ufonzak/weather-station/pcb/pcb.kicad_pcb

## KiCad design pcb/pcb.kicad_pcb (2021-03-13)

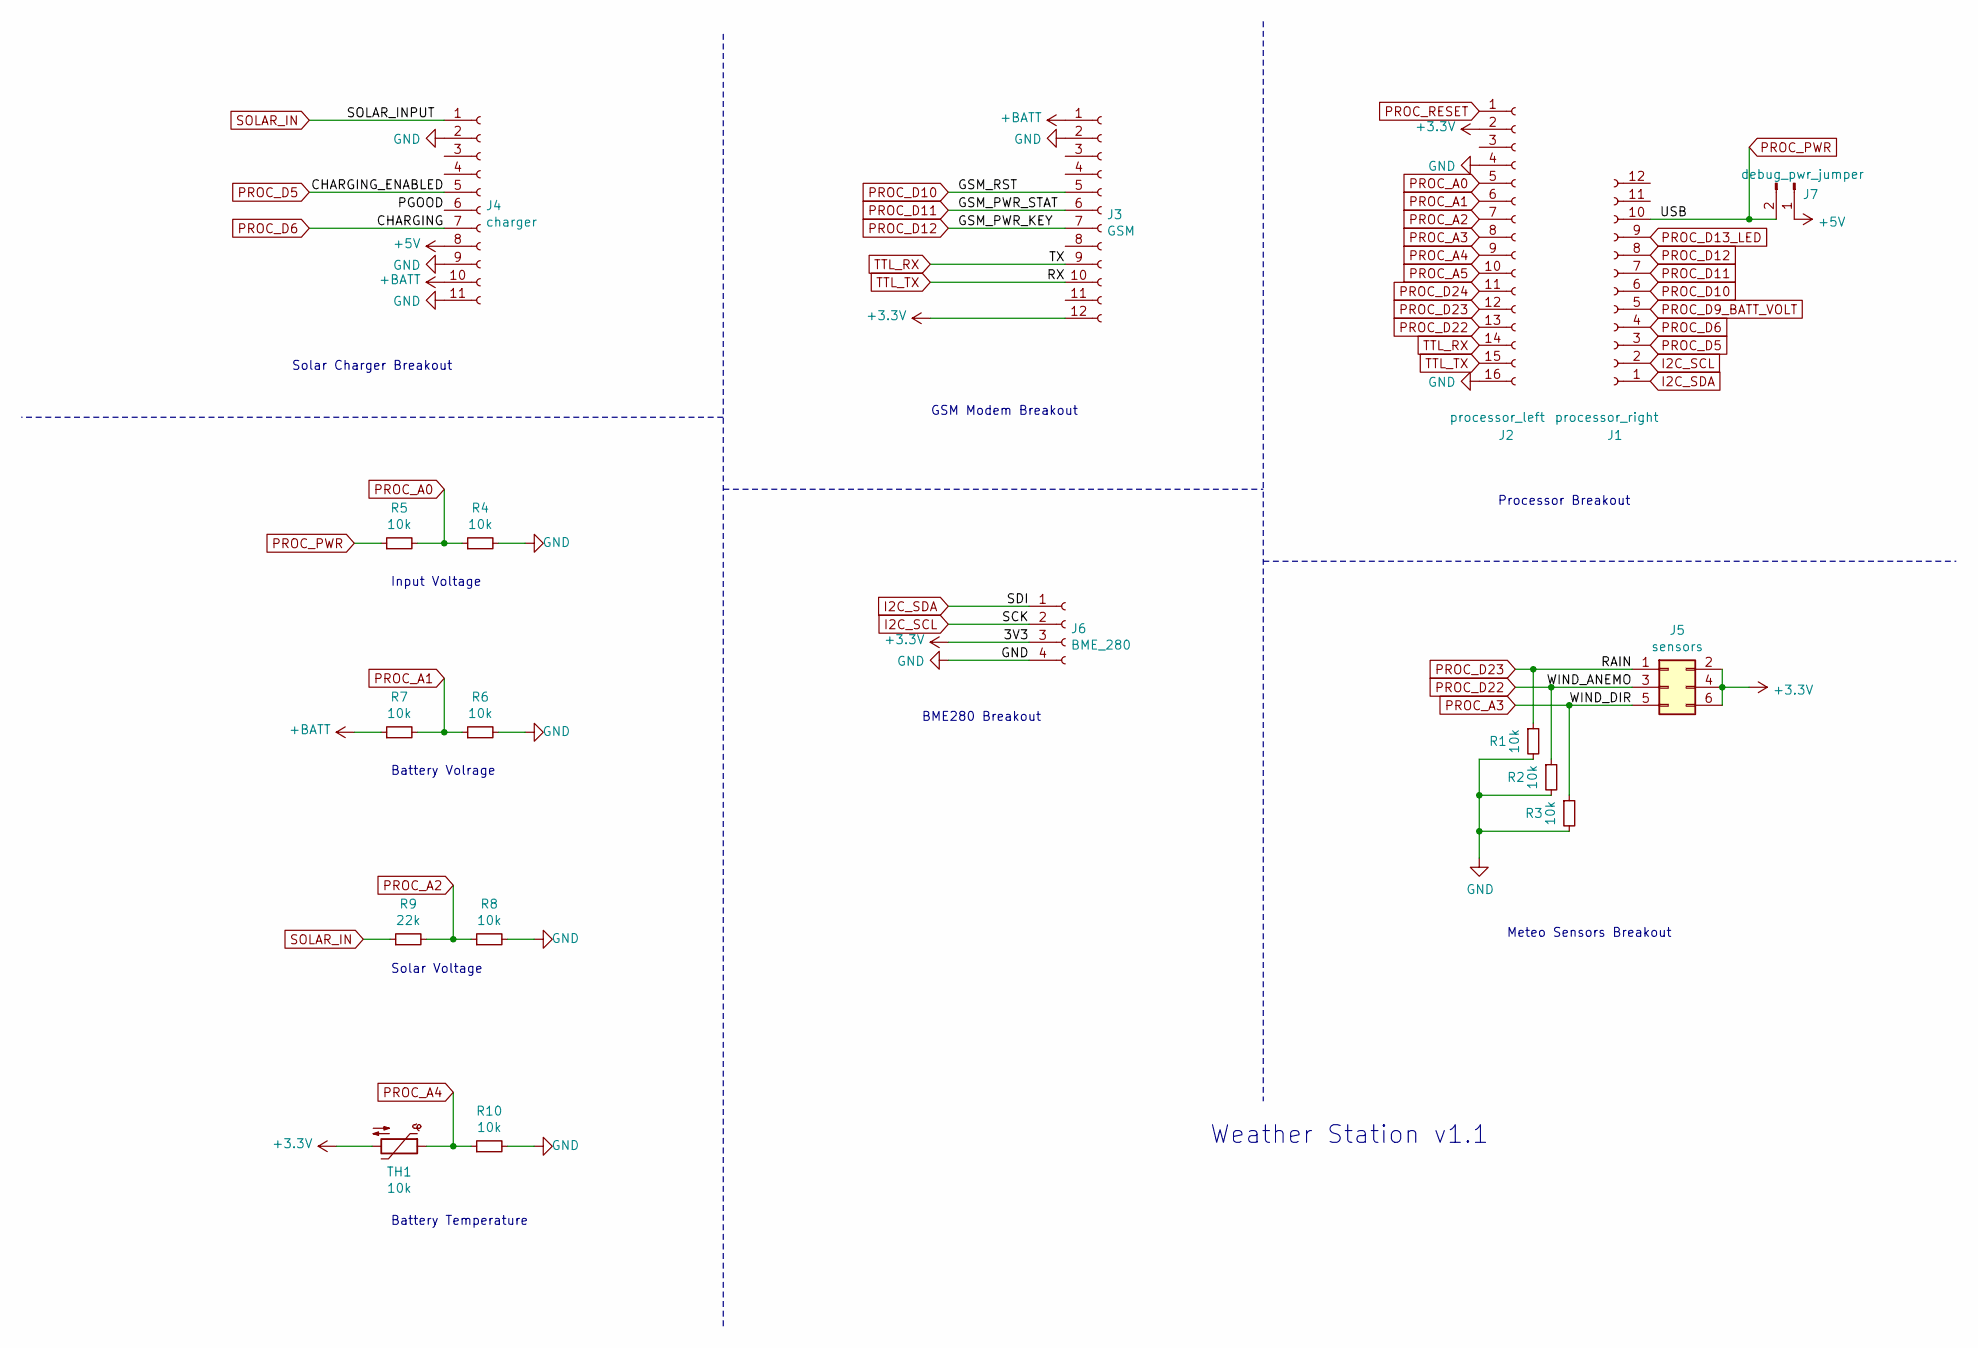
[picture p1: schematic pcb.sch]

Parts:
J1: processor_right; PinSocket_1x12_P2.54mm_Vertical
J2: processor_left; PinSocket_1x16_P2.54mm_Vertical
J3: GSM; PinSocket_1x12_P2.54mm_Vertical
J4: charger; PinSocket_1x11_P2.54mm_Vertical
J5: sensors; PinSocket_2x03_P2.54mm_Vertical
J6: BME_280; JST_PH_B4B-PH-K_1x04_P2.00mm_Vertical
J7: debug_pwr_jumper; PinHeader_1x02_P2.54mm_Vertical
R1, R2, R3, R4, R5, R6, R7, R8, R10: 10k; R_Axial_DIN0207_L6.3mm_D2.5mm_P10.16mm_Horizontal
R9: 22k; R_Axial_DIN0207_L6.3mm_D2.5mm_P10.16mm_Horizontal
TH1: 10k; R_Axial_DIN0204_L3.6mm_D1.6mm_P5.08mm_Horizontal

Connections:
+3V3: J2.2, J3.12, J5.2, J5.4, J5.6, J6.3, TH1.2
+5V: J4.8, J7.1
+BATT: J3.1, J4.10, R7.1
/PGOOD: J4.6
GND: J2.4, J2.16, J3.2, J4.2, J4.9, J4.11, J6.4, R1.2, R2.2, R3.2, R4.2, R6.2, R8.2, R10.2
I2C_SCL: J1.2, J6.2
I2C_SDA: J1.1, J6.1
PROC_A0: J2.5, R4.1, R5.2
PROC_A1: J2.6, R6.1, R7.2
PROC_A2: J2.7, R8.1, R9.2
PROC_A3: J2.8, J5.5, R3.1
PROC_A4: J2.9, R10.1, TH1.1
PROC_A5: J2.10
PROC_D5: J1.3, J4.5
PROC_D6: J1.4, J4.7
PROC_D9_BATT_VOLT: J1.5
PROC_D10: J1.6, J3.5
PROC_D11: J1.7, J3.6
PROC_D12: J1.8, J3.7
PROC_D13_LED: J1.9
PROC_D22: J2.13, J5.3, R2.1
PROC_D23: J2.12, J5.1, R1.1
PROC_D24: J2.11
PROC_PWR: J1.10, J7.2, R5.1
PROC_RESET: J2.1
SOLAR_IN: J4.1, R9.1
TTL_RX: J2.14, J3.9
TTL_TX: J2.15, J3.10

Notes on the sheet:
Processor Breakout
Meteo Sensors Breakout
BME280 Breakout
Input Voltage
Battery Volrage
Solar Voltage
Battery Temperature
GSM Modem Breakout
Solar Charger Breakout
Weather Station v1.1

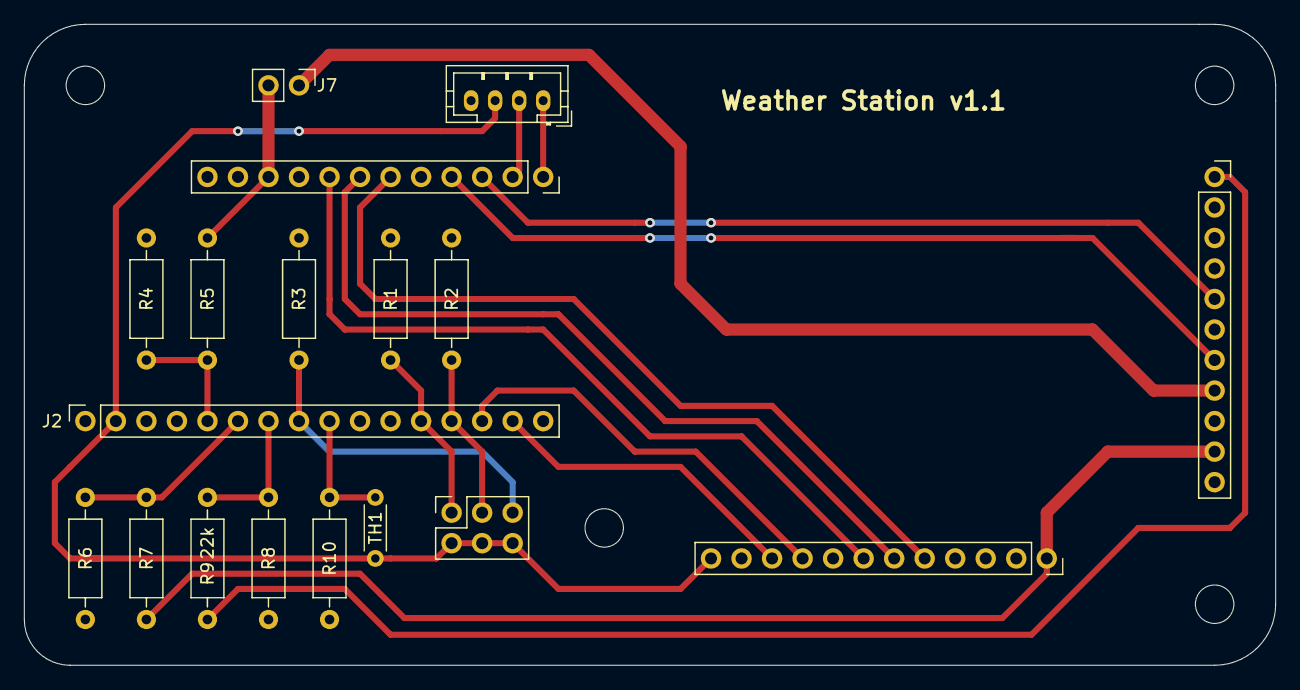
[picture p2: board pcb.kicad_pcb from above]

Board: 2 copper layers, 104.1 x 53.3 mm, 18 parts (0 on the bottom side), 22 nets.
