ufonzak/weather-station/(commit log)

2020-10-27 Voltage measuring.
2020-11-02 Power supply regulations
2020-11-15 Measuring battery tep
2021-01-04 Automate reseting of i2c
    [gsm-voltage.ino, weather.h]
2021-02-24 Doubling line thickness
    [pcb.kicad_pcb]
2021-03-01 New pins, data format and battery charging control.
2021-03-13 New PCB.
2021-03-20 Resetting on sending failure.
    [gsm-voltage.ino]
2021-04-10 Separating temperature and cycle control.
2023-03-26 Fixes and camera integration.
